jantman/electronics-projects/README.md

# electronics-projects
Miscellaneous electronics projects that aren't big enough for their own repo
