jantman/electronics-projects/as3935_lightning_detector/loop-rotator-dial.pdf

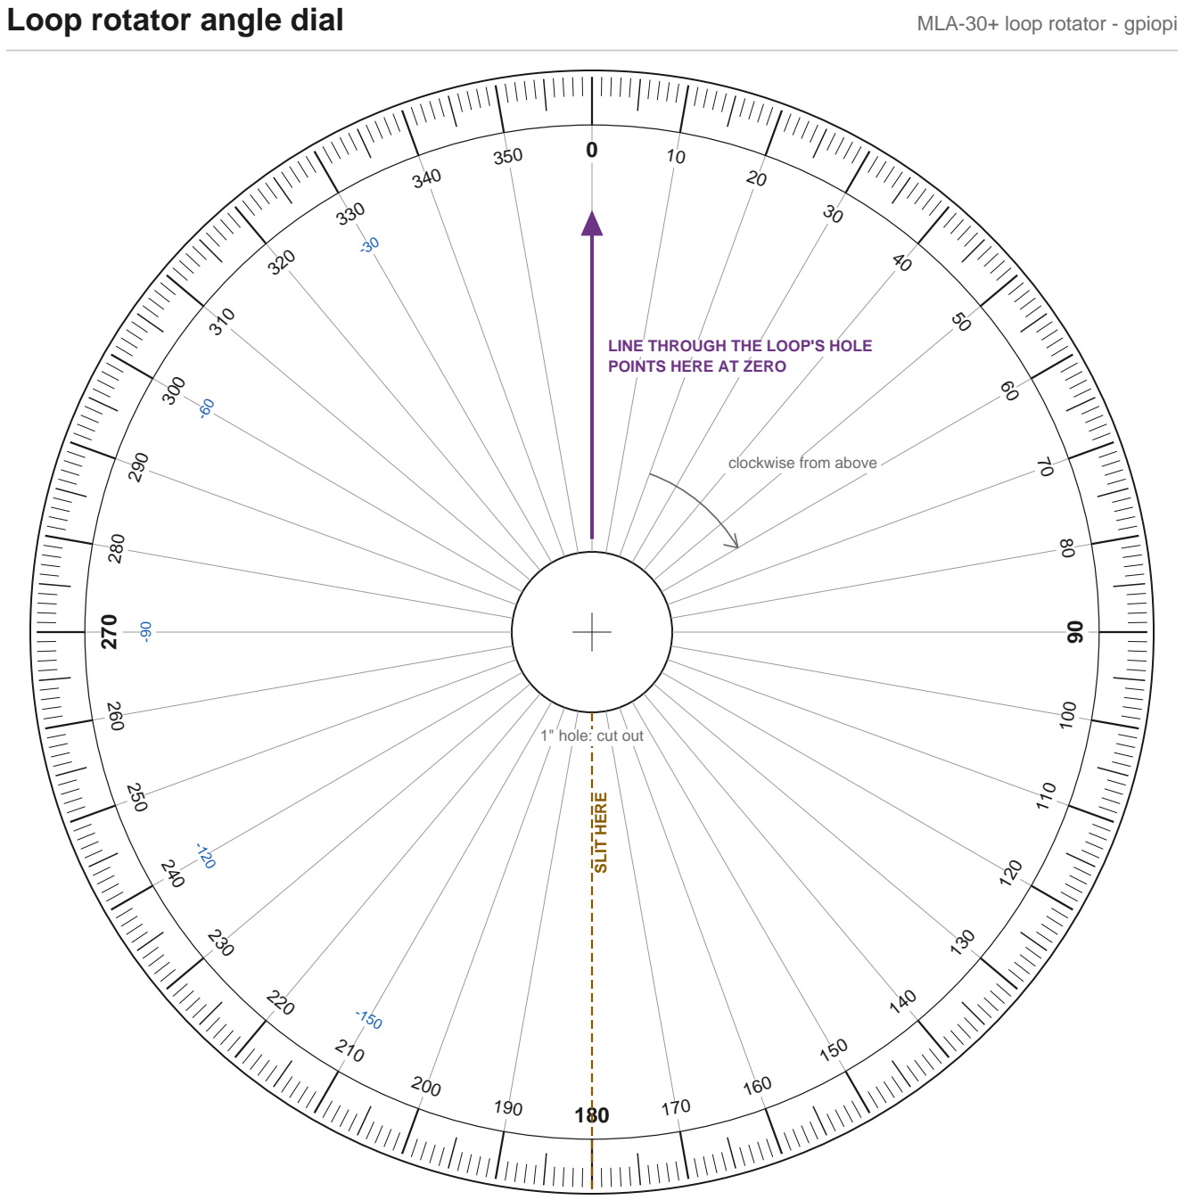
[picture p10: figure]
Loop rotator angle dial; MLA-30+ loop rotator - gpiopi; 180 ¹⁹⁰; LINE THROUGH THE LOOP'S HOLE POINTS HERE AT ZERO; SLIT HERE; 1" hole: cut out; clockwise from above

3 in

5 cm
1. Print at 100% / actual size. Check both bars above before cutting; the dial is 7" across.
2. Cut the outer circle and the 1" hole. Slit along the dashed line at 180.
3. Slip it round the mast under the shaft collar's bearing and tape it to the plate.
4. The dial stays still and the mast turns. Mark the shaft collar on the line through the loop's hole and read the mark against the grey spokes (every 10 deg). For 1 deg, a straw or stiff wire taped to the collar can reach out over the graduations at the rim.
5. Blue figures are loop-rotator's negative angles: goto -30 reads 330 on the dial.

DRAWING DATED 2026-11-07
