jantman/electronics-projects/(commit log)

2026-08-09 Fix AS3935 capacitance units and correct ESPHome config documentation
    The `capacitance` option of ESPHome's as3935 component is the raw TUN_CAP
    register value in 8 pF steps (validated 0-15), not a value in picofarads.
    The README instructed setting it to the label's pF value, which produced a
    placeholder of 96 in the YAML and fails config validation outright with
    "must be between 0 and 15". The board label reads 72 pF, so the correct
    value is 72 / 8 = 9.
    Verified against the upstream component: the schema is
    cv.int_range(min=0, max=15), and as3935.cpp writes the value directly while
    multiplying by 8 only for the log line ("Setting tune cap to %d pF"). That
    log line is now documented as the c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
2026-08-09 Align lightning detector config with standard ESP32 node conventions
    Brings lightning-detector.yaml in line with the conventions used by the
    other ESP32 nodes: esp-idf framework instead of arduino, the
    esp32-lightning-sensor naming, the standard diagnostic sensor set (uptime,
    wifi_signal in dB and %, internal_temperature), a restart button, and the
    wifi domain/reboot_timeout settings. Drops the local web_server. Bumps the
    logger to VERY_VERBOSE for AS3935 bring-up.
    The AS3935 sensor platform moved into the consolidated sensor: block rather
    than remaining a second top-level sensor: key, which keeps the config valid.
    Reviewed against the upstream component sources with no blocking issues:
    -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
2026-08-09 Document that the tune-cap check requires serial, and add it to bring-up
    The "Setting tune cap to N pF" line is emitted from the AS3935 component's
    setup(), which runs before WiFi and the API are up. The ESPHome log stream
    attaches only after boot completes and does not replay boot-time logs to a
    late-connecting client, so this line is never visible over WiFi regardless
    of log level -- and rebooting with the log window open does not help, since
    the API drops and reattaches after setup() has already finished. This was
    hit in practice: VERY_VERBOSE was set and the line still did not appear.
    Confirmed against the component source that the write is unconditional --
    setup() calls write_capacitan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
2026-08-09 Add ESP32 driver sketch for the SEN-39002 lightning emulator shield
    Drives the Playing With Fusion SEN-39002 emulator from an ESP32 wired
    point-to-point on a breadboard, rather than stacked on an Arduino Uno, for
    a one-off bench test of the AS3935 detector through to Home Assistant.
    The shield is two MCP4725 12-bit I2C DACs (0x62, 0x64) driving an air-core
    solenoid. There is no oscillator: the DACs play a decaying staircase and
    each step change kicks the coil, ringing the AS3935's 500 kHz resonant loop
    by near-field magnetic coupling -- hence the centimeter-scale range.
    Far/mid/close are 1/2/3 passes through the identical decay burst; amplitude
    and frequency do not vary, only total energy.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
    [sen39002-emulator-esp32.ino]
2026-08-09 Convert the SEN-39002 emulator sketch to a PlatformIO project
    Restructures the emulator driver into a standalone PlatformIO project so it
    can be built and flashed with `pio run -t upload` instead of the Arduino
    IDE. The sketch moves from sen39002-emulator-esp32.ino to src/main.cpp
    (git tracks this as a rename), targeting env:esp32dev / espressif32 /
    arduino.
    Two changes were required by the .ino to .cpp conversion, since .cpp files
    get neither the implicit Arduino.h include nor generated prototypes:
    - Added an explicit #include <Arduino.h>.
    - Replaced the range-for over a braced-init-list in the DAC probe with a
    plain array, which avoids depending on <initializer_list> being pulled in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
    [main.cpp]
2026-08-09 Add a comprehensive README for the SEN-39002 ESP32 emulator driver
    Documents the emulator subproject end to end: purpose, parts needed, theory
    of operation, wiring, build and flash, usage, a bench procedure, and
    troubleshooting.
    The theory section is the important part, because it explains every design
    choice that follows. The shield has no RF oscillator -- it is two MCP4725
    I2C DACs playing a decaying staircase into an air-core coil, and each step
    change kicks the coil so the near-field transient rings the AS3935's 500 kHz
    loop antenna. Near, mid and far are 1, 2 and 3 replays of the identical
    burst; only total energy differs, which is why reported distances are
    ordered but not calibrated.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
2026-08-09 Replace the ESP32 SEN-39002 emulator driver with an Arduino Uno one
    A spare Arduino Uno R3 turned up, and the SEN-39002 is an Arduino shield,
    so it now stacks directly on its intended host instead of being wired
    point-to-point to an ESP32. Every compromise the ESP32 port carried is
    gone: the shield runs on its native 5 V rail, there is no I2C logic-level
    hazard against the MCP4725s' 0.7*VDD input threshold, no amplitude fudge
    factor to compensate for a 3.3 V rail, and the onboard pushbuttons and
    LEDs work because D4-D9 are ordinary Uno pins rather than ESP32 SPI-flash
    and strapping pins.
    The new driver starts from Playing With Fusion's own reference sketch
    rather than porting the ESP32 code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
    [main.cpp]
2026-08-09 Correct the DAC model after bringing the shield up on hardware
    Flashing the Uno and reading the boot probe turned up "DAC 0x62: NOT
    RESPONDING / DAC 0x64: OK", which the previous commit's own documentation
    said was a fault. It isn't. The two-DAC model in that commit was wrong.
    An I2C bus scan of 0x08-0x77 on this board finds exactly one device, at
    0x64. 0x62 and 0x64 are the MCP4725A1 and MCP4725A2 part variants, not two
    chips: the shield carries one, and PWFusion writes to both addresses so a
    single sketch covers either. That is what their 2024Feb25 revision note,
    "Update to support additional I2C addresses", actually means. Nothing is
    broken and drive strength is not halved -- this is the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
    [main.cpp]
2026-08-09 Fix the AS3935 SPI mode, and document the bench interference investigation
    The detector reported nothing at all: ESPHome logged read_interrupt_register_
    in a tight loop with the interrupt register reading 2, forever, and every
    lightning entity in Home Assistant stayed Unknown.
    2 is not a valid AS3935 interrupt code. The chip defines 1 (noise), 4
    (disturber) and 8 (lightning); loop() matches those three and silently falls
    through anything else, publishing nothing. 2 is 4 shifted right one bit.
    The cause is the SPI mode. as3935_spi.h declares CLOCK_POLARITY_LOW plus
    CLOCK_PHASE_LEADING, which is MODE0, and nothing overrides it unless spi_mode
    is set in YAML. The AS3935 is a MODE1 part -- Spa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
    [ambient-survey.py, emulator-trial.py]
2026-08-18 Let ambient-survey.py read a piped log stream, and fix its liveness gate
    The site survey in README section 10 is meant to be run wherever the node is
    mounted, but the tool could only read a USB serial port -- which meant carrying
    a laptop and a long cable into the attic to measure a node that was already
    streaming the exact same messages over WiFi. Every message the survey counts is
    emitted from loop(), so it crosses the API normally; the one genuinely
    serial-only line is the setup() tune-cap message (section 12.1), which this tool
    never reads.
    Add --stdin, mutually exclusive with --port, so the survey can be fed from an
    ESPHome log client:
    esphome logs lightning-detector.yaml | tools/am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
    [ambient-survey.py]
2026-08-19 Interpret the AS3935 distance register as codes, not kilometres
    The first live attic survey reported a lightning event at "63.0 km", which
    ambient-survey.py flagged as a candidate real strike. It is not one, and the
    error was mine.
    REG0x07 bits [5:0] is a lookup table, not a linear value. 1 means the storm is
    overhead, 5 through 40 are real distances, and 63 is the out-of-range code --
    lightning was classified but no distance could be estimated. ESPHome's
    get_distance_to_storm_() returns that raw register value and publishes it
    straight to the distance sensor in km, with no interpretation, so an
    unrangeable event surfaces in Home Assistant as a plausible-looking "63 km"
    strike.
    That is wor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
    [ambient-survey.py]
2026-08-19 Report lightning energy alongside distance in ambient-survey.py
    The first attic baseline produced 137 false INT_L events, every one of them
    reporting distance code 63 (out of range). A follow-up capture showed all of
    them also carried energy 0 -- but only six events were sampled, because the
    survey tool parsed distance and threw the energy line away.
    That matters because zero vs non-zero energy is the difference between two very
    different mitigations. Quieting false lightning by raising spike_rejection
    trades away real strikes to buy the quiet. If false strikes are reliably
    zero-energy, filtering on energy instead costs nothing in sensitivity. Deciding
    between those needs the energy value o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
2026-08-20 Record the garage attic survey: the wall wart is 63% of the disturbers
    Thirteen hours of measurement in the garage attic, config unchanged throughout
    so every run is comparable. Twelve consecutive hours on the wall wart put the
    disturber rate at 63-85/min (mean 72.7) across a full day of varying household
    load. One hour on a USB power bank put it at 26.6/min.
    That is far outside the band the rate held all day, and it is not time of day:
    the wall-wart baseline covered 18:14-19:14 and the power-bank run 17:33-18:33.
    The coupling is substantially conducted, which promotes the section 7.2 RC
    filter from theory to something with a measured path to filter -- and the
    breadboard has none.
    Three re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
2026-08-21 Retract the wall-wart finding: its control refuted it
    Commit 191d4c1 reported that the wall wart accounted for ~63% of the
    disturbers, on the strength of one hour on a USB power bank: 72.7/min dropped
    to 26.6/min, far outside the band the rate had held across thirteen hourly
    runs. That conclusion was wrong.
    Restoring the wall wart left the rate at 25.7/min. The A' control does not
    reproduce phase A, so the power source was never the variable.
    What the step change actually coincides with is the node being physically
    handled -- 17:33 was the first time anyone had touched the build since it
    booted two days earlier, and the rate has stayed near 26/min through two power
    cycles since. Ruled out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
2026-08-21 Document the project state so it can be picked up from a clone alone
    The README had grown into a good record of individual findings but not of
    where the project actually stands. Someone cloning it would have learned a lot
    about SPI modes and disturber rejection without discovering that the build
    cannot be measured on or that per-strike events never reach Home Assistant.
    Add a status banner ahead of section 1 stating plainly what works, what blocks
    progress, and what has never been validated. The two blockers are the
    breadboard platform and the dead per-strike path; neither is the sensor.
    Add section 8.4 for the Home Assistant failure, which was previously recorded
    nowhere in the repo. The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
2026-08-22 Specify hardware revision 2: two enclosures, USB power, RJ45 interconnect
    Settles the design questions section 16 had left open, and corrects the parts of
    the documentation that described a supply which was built and does not work.
    The IRM-02-5 was built and browned out. 2 W is 400 mA at 5 V; ESP32 WiFi bursts
    approach 500 mA, or ~2.5 W. A 2-3 A USB brick fixed it immediately. Worth
    recording that the warning was already in this README -- "400 mA is tight for an
    ESP32 on WiFi (TX bursts approach ~500 mA)" sat in section 5 while the part
    stayed in the BOM. A margin note saying a part is marginal is a rejection.
    Architecture is now two enclosures joined by a swappable Cat5 patch cable.
    Near-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
    [make-wiring-diagram.py]
2026-08-22 Characterise the noise floor, and split the per-strike work out of the main line
    Two documentation changes, one analytical and one structural.
    Section 11.5 is new: what the INT_NH noise floor actually is, from the 168
    five-minute buckets already collected. It is bimodal - a quiet cluster around
    250-350 counts per bucket and a loud mass around 900-1500, with a sparse valley
    between - so a discrete source is switching rather than an ambient level
    drifting. It is irregular, with 10-90 minute runs in each state, no periodicity
    and no diurnal trend. And nothing in the house tracks it: mean power across all
    62 usable per-circuit series differs by only ~5% wobbles on multi-kW rollups
    between loud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
2026-08-22 Add a standalone guide for the SDR interference hunt
    Section 11.5 leaves the noise floor characterised but unexplained, and names an
    SDR as the instrument that would resolve it. This is the guide for that, written
    now while the reasoning is fresh so the work can be picked up cold later.
    Leads with the case for NOT buying anything yet: every noise-floor number came
    from the platform section 11.3 disqualified, so rebuild and re-measure first,
    then try the rotation test, which is free because the AS3935's antenna is
    already a tuned 500 kHz loop with sharp nulls. The SDR earns its place only if
    the noise survives the rebuild and rotation is inconclusive -- it answers what
    the signal is, which r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
2026-08-26 Plan the rev 2 boards hole by hole on 0.1" perf
    The wiring diagram says what connects to what; it does not say where
    anything sits. That is the part that decides whether the sensor board is
    an instrument or furniture, so it needs its own drawing.
    Adds make-protoboard-layout.py and the five-page PDF it generates:
    placement and point-to-point wiring for each board, then build order and
    the traps. README section 7.5 carries the same coordinates in text so a
    clone without a PDF viewer still has them.
    The layout encodes three decisions worth stating:
    - Two ground nodes, tied at exactly one hole. PG carries the cable
    return, the bulk cap and the LDO reference; SG carries only the
    sensor's G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
2026-09-01 Correct the drawings to the parts actually on the bench
    Five defects, reported after reading the drawings against the hardware in
    hand. Four were wrong facts; the fifth was a question the documentation
    never answered at all.
    Sensor enclosure page drawn part by part. It previously collapsed R1, C2,
    U1, C3 and C4 into one box captioned "Local 3.3 V rail" -- the majority of
    the project, hidden. All five are now drawn individually with the PG and SG
    rails as separate bars and the single tie between them called out. Drawing
    it properly forced a detail that had been implicit: C3 lands on PG and C4
    on SG, because C3 is the regulator's stability capacitor and C4 is the
    sensor's decoupling. Swapping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
    [make-protoboard-layout.py, make-wiring-diagram.py]
2026-09-09 Fit 68 ohm series terminators, and stamp both drawing sets with a shared version
    Two changes, prompted by a question from the bench: why do R2/R3/R4 carry an
    "R" prefix if they are wire links, and should they be resistors after all.
    They should. R2/R3/R4 are now 68 ohm 1/4 W, fitted from the start, and the
    reasoning is written down in a new subsection of README 7.1 rather than left
    implicit.
    The old guidance -- links on day one, fit resistors only if the distance sweep
    misbehaves -- was watching for a symptom this fault does not produce. Three
    steps to that:
    - What makes the cable electrically long is the EDGE rate, not the clock rate.
    The ESP32's edges stay a few nanoseconds however sl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
2026-09-09 Stamp the drawings with a date, not a version number
    The stamp added an hour ago read "DRAWING SET v1", on pages that already carry
    "revision 2" in the header -- the HARDWARE revision from README 16. Two
    unrelated small integers on one page invite exactly one question, which is the
    one that got asked: which of these is the version, and was it 2 before?
    It was not: no drawing in this repo carried a version stamp before today, back
    through the original commit in July. The 2 is hardware.
    Renumbering to v2 would have been worse. It would have agreed with the hardware
    revision by coincidence and then diverged silently the first time either one
    moved, which is the same failure with a longer fuse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
    [make-protoboard-layout.py, make-wiring-diagram.py]
2026-09-10 Stand the main board's RJ45 on its edge, and move the SPI pins to meet it
    The main board now takes the RJ45 breakout (J1) soldered straight into the
    perf rather than on a pigtail, on the 17-row board actually in hand rather
    than the 19 drawn. Both facts constrain the layout hard, and one of them
    reaches into the firmware.
    J1 mirrored. Its right-angle header goes into the bottom row, so the breakout
    stands on edge and the jack must face off the board, not into it. That fixes
    the pin order: header down, looking into the jack, the pins read
    SH 8 7 6 5 4 3 2 1, so SH now sits at the USB end.
    Resistors pin to pin, which forced new GPIOs. With 17 rows there is no room
    for a resistor footprint be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
    [make-protoboard-layout.py, make-wiring-diagram.py]
2026-09-11 Draw the sensor board on the real 1-18 x A-X perf, labelled as printed
    The sensor layout was drawn on a 27 x 17 grid that matches no board in hand.
    The stock is 1-14 x A-T, 1-18 x A-X, 1-24 x A-R and 1-30 x A-Y, all lettered
    one way and numbered the other. The parts need only 17 x 13 holes; what sets
    the width is the SEN-39003 itself, about 25 mm square off its header. Of the
    four, 1-18 x A-X takes the existing, already-verified layout with no holes
    moving and the sensor overhanging the X edge by only ~5 mm, and its letters
    run along the long side, so a landscape drawing reads straight off the
    silkscreen. 1-24 x A-R is the same size but lettered the other way round;
    1-14 x A-T would hang the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
2026-09-11 Rebuild the sensor board around the real SEN-39003 pinout and a board-mounted J2
    Four corrections from the bench, each of which moved the layout:
    1. The SEN-39003 pinout is now confirmed on the part. Antenna right, header
    left, top to bottom: VDD, GND, CS, SI, IRQ, SCK, MISO, MOSI. The drawing
    had carried a guessed order with a "verify" flag. VDD and GND are the top
    two pins and adjacent, so C4 now bridges them at R17/R16, one hole from
    each -- the tiny loop that is the point of the part.
    2. The header goes in column S or beyond for the loop antenna to clear the
    board. It is in S -- the nearest column that achieves that, which keeps as
    much of the breakout over the perf a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
    [make-protoboard-layout.py, make-wiring-diagram.py]
2026-09-12 Correct the MCP1700 pinout and stand U1 down a column to reach its middle pin
    The sensor board drew U1 with its pins as VIN, GND, VOUT -- the familiar 78xx
    order -- and as a plain rectangle. Both were wrong. The MCP1700-3302E in TO-92
    reads GND, VIN, VOUT left to right, flat face toward you and leads down. Built
    as drawn, 5 V would have gone onto its ground pin.
    The correct order puts VIN in the middle, flanked by GND and VOUT, so the
    5 V bus can no longer run along a row to reach it without passing GND. U1 now
    stands with its leads down column M and its flat face toward C3:
    VOUT M18 straight onto BUS-B (now M-R)
    VIN M17 W-S4, from the end of BUS-A (now H-K)
    GND M16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
    [make-protoboard-layout.py, make-wiring-diagram.py]
2026-09-13 Set the three logging/reboot values that were quietly sabotaging bench runs
    All three defaults are fine in the attic and wrong on the bench, and each
    fails silently rather than loudly, which is why none of them turned up
    before. Verified against ESPHome 2026.8.2; `esphome config` still reports
    valid, with only the known GPIO5 strapping warning (README 7.1).
    logger: VERY_VERBOSE -> VERBOSE. Every message this project actually reads
    is an ESP_LOGV call site, i.e. VERBOSE, not VERY_VERBOSE: the as3935
    INT_NH / INT_D / INT_L lines, as3935_spi's read_register_, the "Setting
    tune cap to 72 pF" line from setup() that README 12.1 turns on VERY_VERBOSE
    for, and the "'Lightning Distance' >> 63.0 km"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
2026-09-13 Add a WiFi log bridge through the ESPHome dashboard, validated against serial
    ESPHome does not run on the workstation -- it runs on a server behind the
    ESPHome Device Builder dashboard -- so the `esphome logs ... |
    ambient-survey.py --stdin` pipe the tools README described had nothing to
    call. That left serial as the only way to survey, which ties the node to a
    laptop: exactly the noise source and supply a laptop-free run on the USB
    brick is meant to remove.
    tools/ws-log-bridge.py speaks the dashboard's own websocket protocol,
    reverse-engineered from its JS bundle (server 1.1.0, ESPHome 2026.6): a
    hello, auth/login, then devices/logs with port OTA, whose "output" events
    are printed one log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
    [ws-log-bridge.py]
2026-09-13 Record the rev 2 bench bring-up: every check passes but the brick 5 V reading
    Both boards were soldered and brought up on the bench on 2026-09-13 (laptop
    USB, 1 ft Cat6 patch, VERBOSE, bench-tuned config). New section 12.2 holds
    the results:
    - 5 V at the ESP32 5V pin with WiFi active: 4.65-4.79 V, the same at J1.
    Marginal against section 7.4's ~4.7 V, but on laptop USB, not the
    specified brick -- still owed.
    - Sensor VDD: 3.333 V.
    - SPI in Mode 1 at 200 kHz, every register reading back as configured.
    - Tuning capacitance: the chip's own TUN_CAP reads back 9 = 72 pF, which
    is stronger evidence than the software-printed section 12.1 line.
    - Oscillator calibration succeeds.
    - Emulator: C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
2026-09-13 Record the first rev 2 Phase 2 attempt as inconclusive, and set up the next one
    Bench bring-up finished with the brick: 4.823 V at the sensor board with
    WiFi active, so section 12 step 2 passes and every bring-up check is now
    green. The rest of the afternoon was a first attempt at section 15 Phase 2,
    and it did not produce a verdict. New section 11.6 records why, with the
    data.
    In one power-down the build was handled, the 1 ft patch cable was swapped
    for 5 ft, and the supply went from laptop USB to the brick. Surveys over
    WiFi afterwards:
    12:13-12:23 (before, serial) 0 disturbers
    13:05:40-13:40:40 49 = 1.4/min, peak 12 in 5 min
    13:40:40-14:00:40 2 (operator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
    [ws-log-bridge.py]
2026-09-14 Record Phase 2 passing in the woodshop, with a liveness check between the hours
    Both boards moved together to the woodshop workbench, a quiet corner of
    the basement, with nothing else changed: same Samsung 2 A brick, same 5 ft
    patch cable, same bench-tuned config. New section 11.7 holds the results,
    all surveyed over WiFi through ws-log-bridge.py:
    14:50:45-15:51:05 hands off, after the move 0 / 0 / 0
    17:51:12-17:54:40 emulator presses, then handling 0 L / 15 D / 1 N
    17:54:59-18:55:05 hands off, after handling 0 / 0 / 0
    The first hour's zero could equally have been a cable pulled loose in the
    move, since the survey's health gate proves the log stream and not the
    sens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
2026-09-18 Record the finished build's ten-hour baseline and its second liveness check
    Both boards are now in ABS boxes sized to fit them, on a 22 AWG micro-USB
    cable with the brick on a short mains extension so the USB run stays
    short. New section 11.8 holds what the finished build measured, still on
    the woodshop bench:
    2026-09-16, ten hourly surveys, 06:18-16:24, unattended
    0 false lightning, 0 noise, 3 disturbers = 0.005/min
    09:44:09, 11:43:00, 13:11:00; no reboot, ~640 log lines an hour
    2026-09-18, liveness check in the enclosures
    17:35:41 basement lights (~909 W) switch on 1 disturber
    ~17:38 Uno powered up a few feet away nothing
    17:41:38 Uno powered up besid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
2026-09-19 Design the MQTT per-strike pipeline, and wire the node to publish it
    The goal this project was built for -- every strike the AS3935 can detect,
    visualised by distance and time -- cannot be reached through Home
    Assistant, and section 8.4 is only the first symptom. Three separate
    data-model problems sit on that path: HA stores state changes, so two
    identical strikes collapse into one; Prometheus-via-HA is gauge sampling,
    which cannot represent an event stream at all; and the 10 ms Storm Alert
    pulse (measured at 79 ms) is the wrong signal shape for anything
    downstream. New strike-pipeline-design.md records the design that routes
    around all three, and lightning-detector.yaml now implements the n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
2026-10-10 Add window-report.py, and stop needing surveys to see disturbers
    window-report.py is the scoring instrument for the attic interference
    hunt. Per day and per scheduled window (00:36, 04:10, 12:10, 18:00,
    20:10) it reports:
    - the strikes, with their (boot, seq) range and codes;
    - the disturber and noise-floor interrupts;
    - whether the pipeline stayed healthy across the window, without which a
    quiet window proves nothing (§11.7).
    It also lists oven sessions, flags any window one overlaps, and lists
    strikes that fall in neither. Each switch-off experiment becomes one run
    of this. Standard library only.
    None of it needs a survey running. Strikes come from lightning-bridge's
    lossless Loki lin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
2026-10-10 Revise the SDR guide for the RTL-SDR Blog V4's end of production
    The guide said "Get the V4. Not the V3." The V4 is now end-of-line. Its
    R828D tuner is out of production, and RTL-SDR Blog says the last chips
    they could get were all faulty. They also warn that most marketplace
    "Blog V4" listings are V3-clone boards in copied cases, which matches
    what Amazon offered on 2026-10-10: $80 with two-week shipping, $150 with
    a month.
    The receiver section is now a table of what can actually be bought:
    - the V3, in stable production;
    - the V4L "Lite" (R828S), $37.95 from the official store, keeping the
    upconverter and HF gain but with a diplexed rather than triplexed input;
    - the NESDR SMArt v5;
    - t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
2026-10-15 Add the loop rotator's wiring and setup drawing, and its generator
    A four-page printable set for motorising the MLA-30+ direction-finding
    loop on gpiopi: overview and parts, point-to-point wiring (W1-W11, R1-R4),
    the mechanical stack under the mast, and a bring-up checklist through the
    first AM-station calibration sweep.
    It records two things the MPJA L298 module's schematic showed that are
    easy to get wrong: J-1 ties the logic 5 V rail to the motor supply, so it
    must be REMOVED on 12 V (the 78M05 makes logic 5 V, and the +5V terminal
    is its output); and IN1-IN4 have no pull resistors, hence the 10k
    pull-downs.
    The software is loop-rotator, puppet-managed on gpiopi in privatepuppet;
    pins a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
2026-11-07 Put the loop's null axis on 0 deg in the loop-rotator drawing
    The top view on page 3 had the loop's plane on the 0-180 line, so the
    null axis (the line through the hole) sat at 90 deg and every null angle
    needed 90 deg added to become a bearing. The rotator as built was zeroed
    with the axis on 0 deg instead, which is the easier convention: the null
    angle loop-rotator reports is then the source's plate bearing directly,
    or its reciprocal, and analyze already prints both.
    - Top view: loop drawn edge-on along 90-270, dashed null axis on 0-180.
    - "Reading a bearing" rewritten for that convention.
    - Bring-up step C says to aim the line through the hole at 0 before
    `loop-rotator zero`, rather t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
2026-11-07 Add a printable angle dial for the loop rotator's base plate
    The plate has no graduations, so there is nothing to read the loop's
    angle against for `loop-rotator zero` and the direction and repeatability
    checks in bring-up step C.
    loop-rotator-dial.pdf is a 7" paper dial with a 1" centre hole and a
    slit along 180 deg, so it slips round the mast under the shaft collar's
    bearing and tapes to the plate:
    - 1 deg graduations, labelled every 10 deg, clockwise from above to
    match loop-rotator.
    - 0 deg is where the line through the loop's hole points at zero, the
    convention adopted in the setup drawing (23026e9).
    - loop-rotator's negative angles in blue every 30 deg, since goto -30
    lands on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
2026-11-07 Run spokes from the dial's major divisions in to the centre hole
    The plan is to read the angle from a mark on the shaft collar at zero,
    not from a pointer reaching out to the rim, so the 10 deg divisions now
    continue as thin grey spokes from the graduation ring to the 1" hole.
    The collar mark is read against them right at the mast.
    - Spokes stop at 180, where the dashed slit line already marks it.
    - Text that sits on a spoke (the degree labels, the zero note, the
    hole and direction notes) gets a white knockout so it stays legible.
    - Fitting note 4 now describes the collar mark; the pointer-to-the-rim
    option stays, for 1 deg readings.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
